da1sh1n/Alvea/kicad/bom.csv

Reference | Qty | Value | DNP | Exclude from BOM | Exclude from Board | Footprint | Datasheet | LCSC Part
C1,C2,C8 | 3 | CL05A105KA5NQNC |  |  |  | easyeda2kicad:C0402 | https://lcsc.com/datasheet/C52923.pdf | C52923
C3 | 1 | ZRB15XR61A475KE01D |  |  |  | easyeda2kicad:C0402 | https://lcsc.com/product-detail/Multilayer-Ceramic-Capacitors-MLCC-SMD-SMT_Murata-Electronics-ZRB15XR61A475KE01D_C703694.html | C703694
C4,C13,C14,C15,C16 | 5 | CL05B104KB54PNC |  |  |  | easyeda2kicad:C0402 | https://lcsc.com/datasheet/C307331.pdf | C307331
C5,C6 | 2 | 0402CG120J500NT |  |  |  | easyeda2kicad:C0402 | https://lcsc.com/datasheet/C1547.pdf | C1547
C7,C9,C10,C11,C12,C17,C18,C19 | 8 | 22uF |  |  |  | easyeda2kicad:C0805 | https://lcsc.com/product-detail/Others_Samsung-Electro-Mechanics-CL21A226KOQNNNE_C296720.html | C296720
D1 | 1 | NSR05F20NXT5G |  |  |  | easyeda2kicad:DSN2_L1.0-W0.6-RD | https://lcsc.com/product-detail/Schottky-Barrier-Diodes-SBD_ON_NSR05F20NXT5G_NSR05F20NXT5G_C94366.html | C94366
F1 | 1 | SMD1206-150C-16V |  |  |  | easyeda2kicad:F1206 |  | C2760275
H1 | 1 | HC-PM254-8.5H-1X3PW |  |  |  | :HDR-TH_3P-P2.54_HC-PM254-8.5H-1X3PW |  | C22373927
L1 | 1 | BRC2016T100K |  |  |  | :IND-SMD_L2.0-W1.6_BRC2016 | https://lcsc.com/product-detail/New-Arrivals_Taiyo-Yuden-BRC2016T100K_C223154.html | C223154
L2 | 1 | 1uH |  |  |  | easyeda2kicad:IND-SMD_L2.5-W2.0 | https://www.lcsc.com/datasheet/C1882521.pdf | C1882521
Q1 | 1 | PMF170XP,115 |  |  |  | easyeda2kicad:SOT-323-3_L2.0-W1.3-P1.30-LS2.1-BR | https://lcsc.com/product-detail/MOSFET_Nexperia-PMF170XP-115_C389353.html | C389353
Q2 | 1 | FS8205A_C2830320 |  |  |  | easyeda2kicad:SOT-23-6_L2.9-W1.6-P0.95-LS2.8-BR |  | C2830320
R1 | 1 | 14k7 1% 0805 |  |  |  | easyeda2kicad:R0805 | https://lcsc.com/product-detail/Chip-Resistor-Surface-Mount-UniOhm_14-7KR-1472-1_C17458.html | C17458
R2,R3,R10,R17 | 4 | 0402WGF5101TCE |  |  |  | easyeda2kicad:R0402 | https://lcsc.com/datasheet/C25905.pdf | C25905
R4,R5 | 2 | 0402WGF1004TCE |  |  |  | easyeda2kicad:R0402 | https://lcsc.com/datasheet/C26083.pdf | C26083
R6 | 1 | WR04W2494FTL |  |  |  | easyeda2kicad:R0402 | https://lcsc.com/product-detail/Others_Walsin-Tech-Corp-WR04W2494FTL_C368359.html | C368359
R7,R18,R19,R23 | 4 | 0402WGF1002TCE |  |  |  | easyeda2kicad:R0402 | https://lcsc.com/datasheet/C25744.pdf | C25744
R8,R11,R22,R24 | 4 | 1k |  |  |  | easyeda2kicad:R0402 | https://lcsc.com/product-detail/Chip-Resistor-Surface-Mount-UniOhm_1KR-1001-1_C11702.html | C11702
R9,R12,R14 | 3 | 0.5Ω |  |  |  | easyeda2kicad:R0402 | https://lcsc.com/product-detail/Chip-Resistor-Surface-Mount_UNI-ROYAL-Uniroyal-Elec-0402WGF500LTCE_C423160.html | C423160
R13 | 1 | RTT022614FTH |  |  |  | easyeda2kicad:R0402 | https://lcsc.com/datasheet/C166493.pdf | C166493
R15,R16,R20 | 3 | 102k |  |  |  | easyeda2kicad:R0402 | https://www.lcsc.com/datasheet/C852473.pdf | C852473
R21 | 1 | 96.5k |  |  |  | easyeda2kicad:R0402 | https://www.lcsc.com/datasheet/C852962.pdf | C852962
SW1 | 1 | TS-1088-AR02016 |  |  |  | easyeda2kicad:SW-SMD_L3.9-W3.0-P4.45 | https://lcsc.com/product-detail/Tactile-Switches_XUNPU-TS-1088-AR02016_C720477.html | C720477
U1 | 1 | E73-2G4M08S1C |  |  |  | :WIRELM-SMD_E73-2G4M08S1C | https://lcsc.com/product-detail/_Chengdu-Ebyte-Elec-Tech-E73-2G4M08S1C_C356849.html | C356849
U2 | 1 | LP5024RSMR |  |  |  | :VQFN-32_L4.0-W4.0-P0.40-TL-EP |  | C427525
U3 | 1 | IP2312 |  |  |  | easyeda2kicad:SOP-8_L4.9-W3.9-P1.27-LS6.0-BL-EP | https://lcsc.com/product-detail/DC-DC-Converters_INJOINIC-IP2312_C605432.html | C605432
U4 | 1 | SN74LVC1G74DQER |  |  |  | :X2SON-8_L1.4-W1.0-P0.35-BL |  | C2870716
U5 | 1 | SN74LVC1G17DBVR |  |  |  | easyeda2kicad:SOT-23-5_L3.0-W1.7-P0.95-LS2.8-BR | https://www.lcsc.com/datasheet/C7836.pdf | C7836
U6 | 1 | SMF5.0A |  |  |  | easyeda2kicad:SOD-123FL_L2.8-W1.8-LS3.6-RD | https://www.lcsc.com/datasheet/C2990427.pdf | C2990427
U7 | 1 | USBLC6-2SC6 |  |  |  | Package_TO_SOT_SMD:SOT-23-6 | https://www.st.com/resource/en/datasheet/usblc6-2.pdf | C7519
U8 | 1 | S2B-PH-K-S(LF)(SN) |  |  |  | :CONN-TH_S2B-PH-K-S-LF-SN | https://lcsc.com/product-detail/PH-Connectors_JST-Sales-America_S2B-PH-K-S-LF-SN_JST-Sales-America-S2B-PH-K-S-LF-SN_C173752.html | C173752
U9 | 1 | MAX17048 |  |  |  | PCM_SparkFun-Semiconductor-Standard:DFN-8_2x2mm_P0.5mm_EP1.2x0.8mm | https://www.analog.com/media/en/technical-documentation/data-sheets/MAX17048-MAX17049.pdf | C2682616
U10 | 1 | DW01A_C42380662 |  |  |  | :SOT-23-6_L2.9-W1.6-P0.95-LS2.9-BL |  | C42380662
USBC1 | 1 | TYPE-C-31-M-12 |  |  |  | easyeda2kicad:USB-C_SMD-TYPE-C-31-M-12_1 | https://lcsc.com/product-detail/USB-Type-C_Korean-Hroparts-Elec-TYPE-C-31-M-12_C165948.html | C165948
X1 | 1 | FC-13532.768KHZ9PF20PPM |  |  |  | easyeda2kicad:OSC-SMD_L3.2-W1.5 | https://lcsc.com/product-detail/SMD-Crystals_EPSON_FC-13532-768KHZ9PF20PPM_FC-135-32-768KHZ-9PF-20PPM_C99010.html | C99010
