da1sh1n/Alvea/kicad/right.pdf

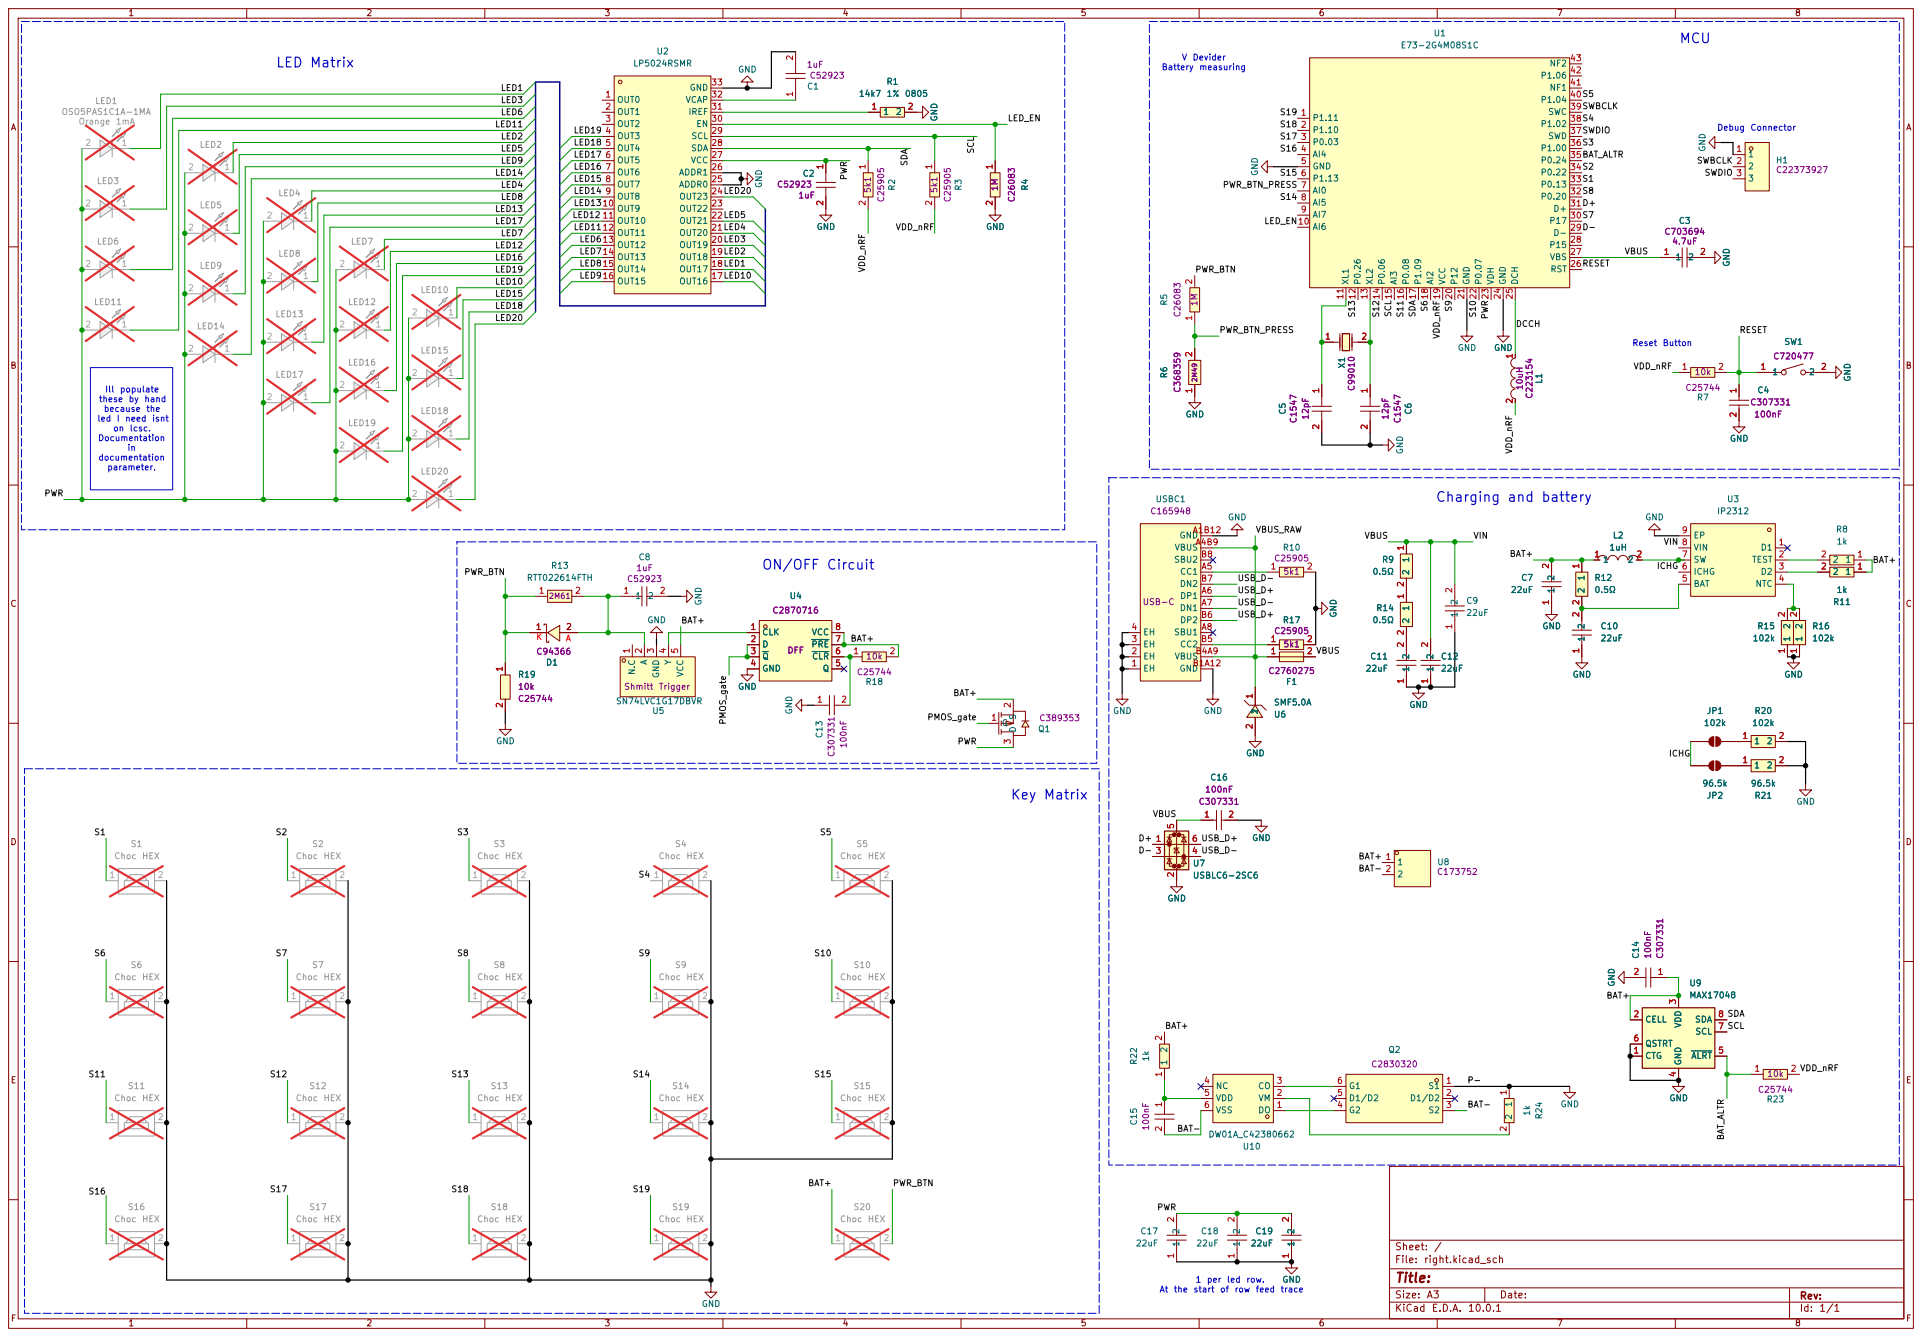
[picture p1: page 1]

Debug Connector V Devider Battery measuring

Ill populate
these by hand
because the
led I need isnt on lcsc. Documentation

1 per led row. At the start of row feed trace

Size: A3 | Rev: | F Date:
KiCad E.D.A. 10.0.1 | Id: 1/1
