da1sh1n/Alvea/kicad/right.kicad_pcb

## KiCad design kicad/right.kicad_pcb (2026-10-15)

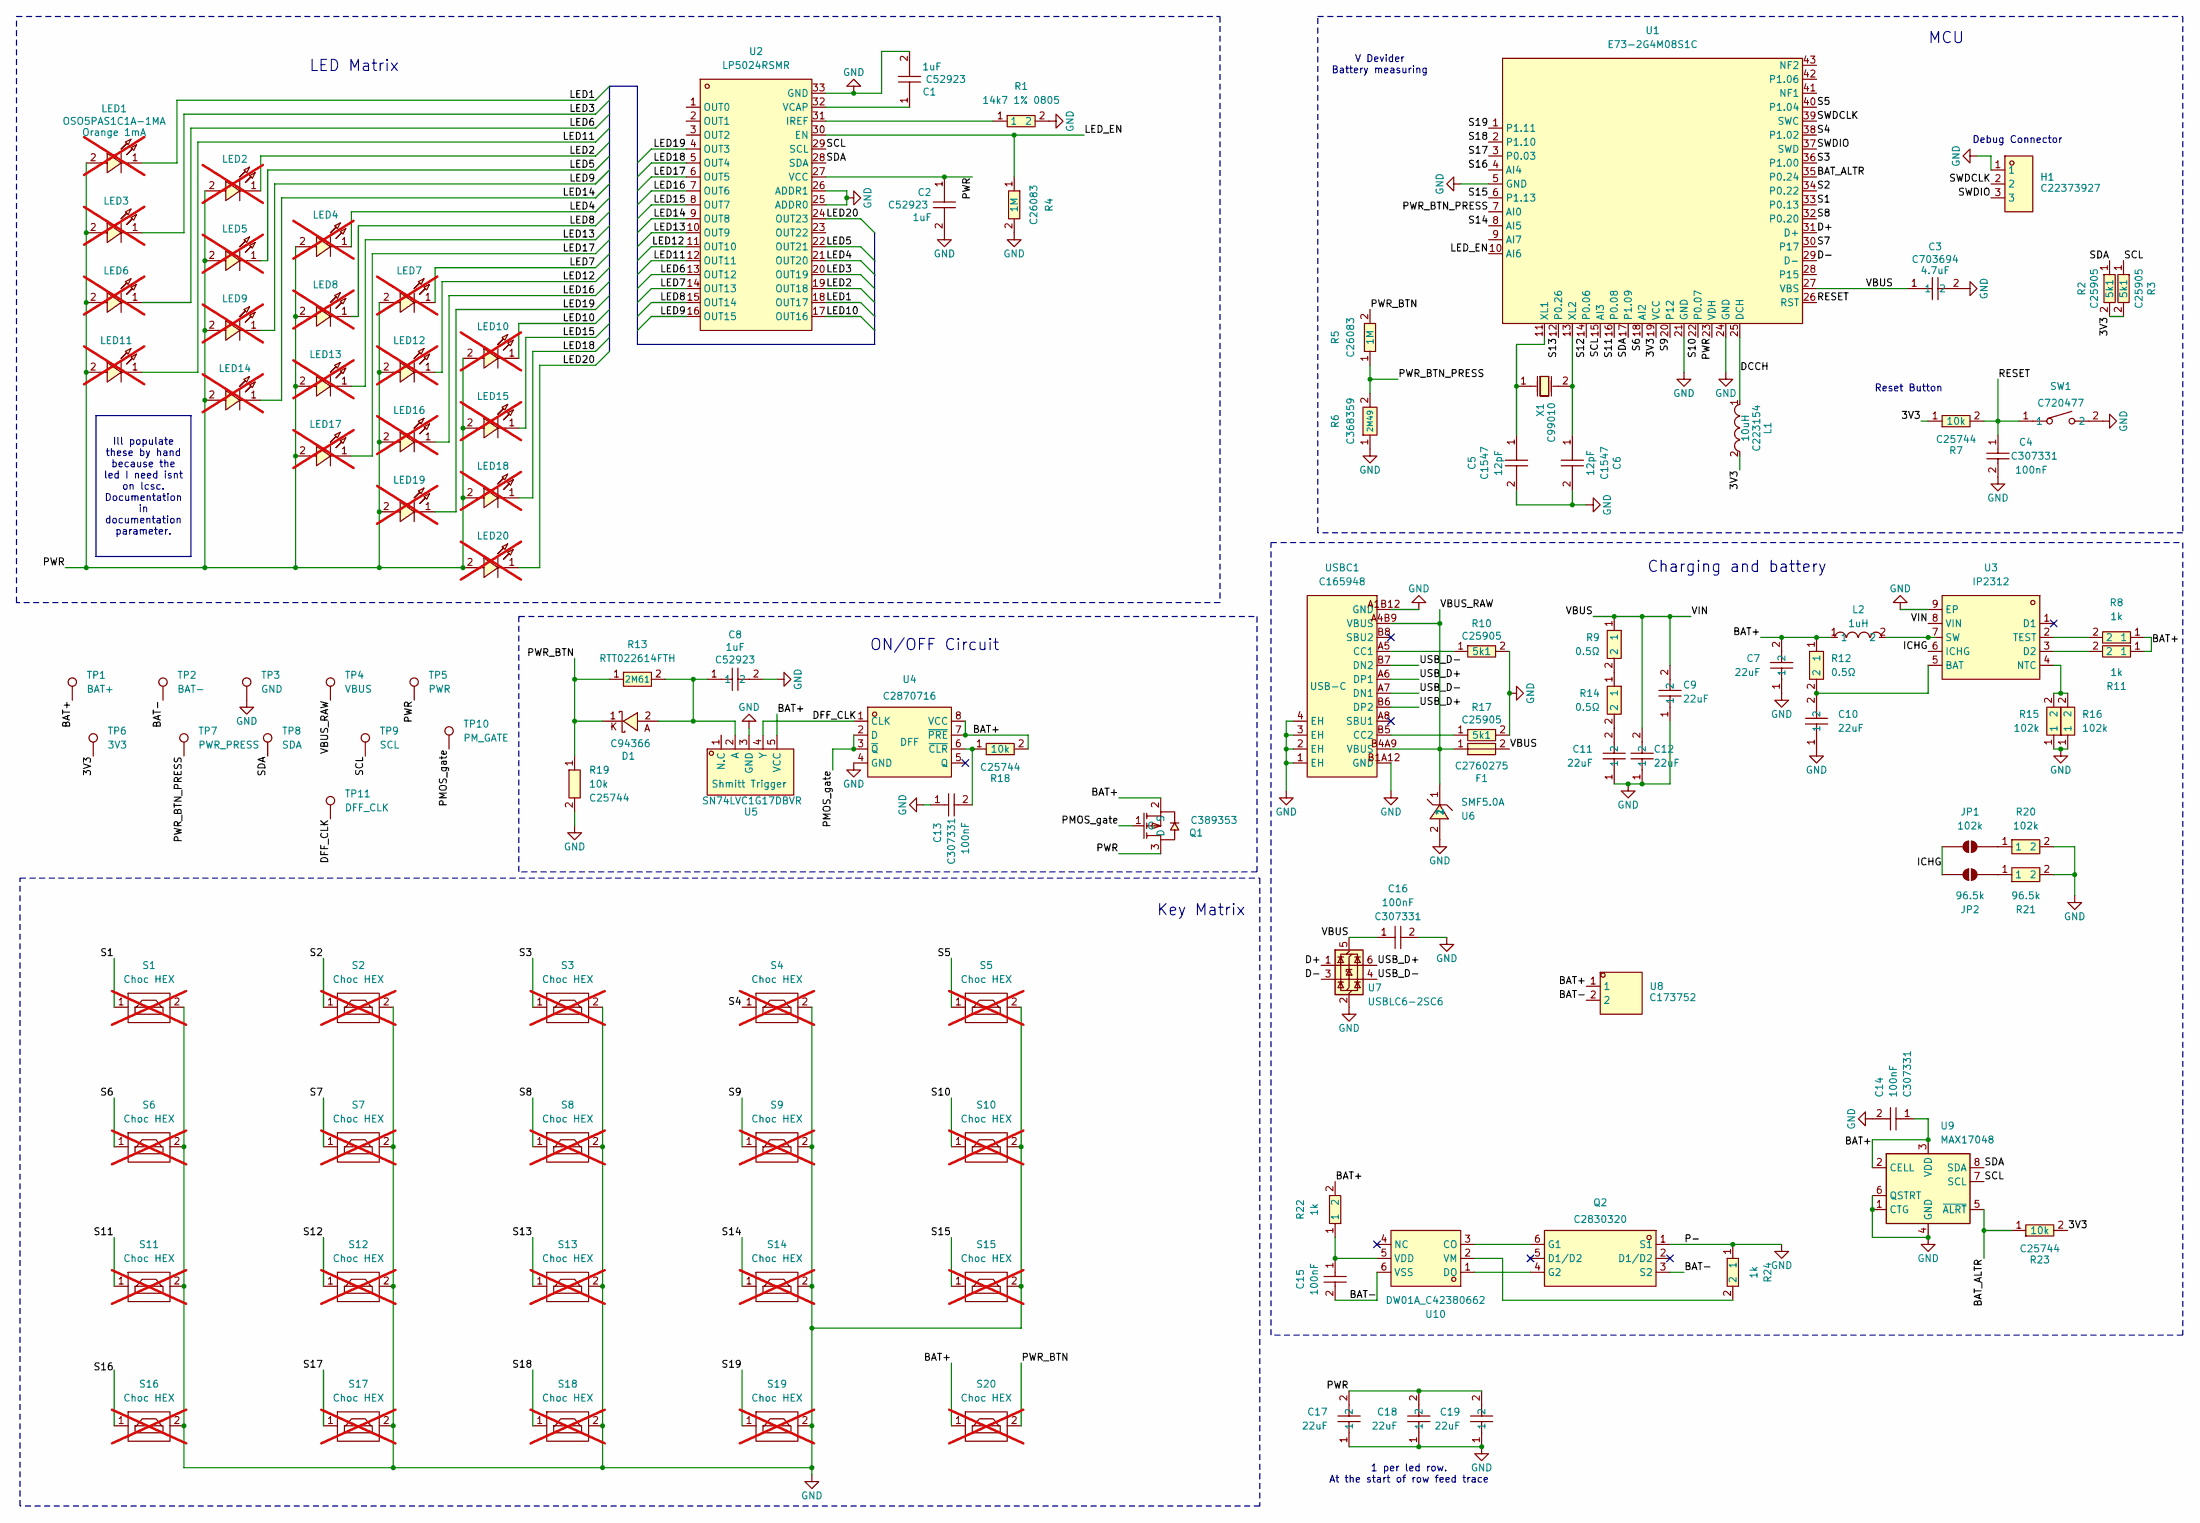
[picture p2: schematic right.kicad_sch]

Parts:
C1, C2, C8: CL05A105KA5NQNC; C0402; LCSC Part C52923
C3: ZRB15XR61A475KE01D; C0402; MPN ZRB15XR61A475KE01D; LCSC Part C703694
C4, C13, C14, C15, C16: CL05B104KB54PNC; C0402; LCSC Part C307331
C5, C6: 0402CG120J500NT; C0402; LCSC Part C1547
C7, C9, C10, C11, C12, C17, C18, C19: 22uF; C0805; MPN CL21A226KOQNNNE; LCSC Part C296720
D1: NSR05F20NXT5G; DSN2_L1.0-W0.6-RD; LCSC Part C94366
F1: SMD1206-150C-16V; F1206; LCSC Part C2760275
H1: HC-PM254-8.5H-1X3PW; HDR-TH_3P-P2.54_HC-PM254-8.5H-1X3PW; LCSC Part C22373927
JP1: 102k; SolderJumper-2_P1.3mm_Open_TrianglePad1.0x1.5mm
JP2: 96.5k; SolderJumper-2_P1.3mm_Open_TrianglePad1.0x1.5mm
L1: BRC2016T100K; IND-SMD_L2.0-W1.6_BRC2016; LCSC Part C223154
L2: 1uH; IND-SMD_L2.5-W2.0; MPN TMS252012ALM-1R0MTAA; LCSC Part C1882521
LED1, LED2, LED3, LED4, LED5, LED6, LED7, LED8, LED9, LED10, LED11, LED12, LED13, LED14, LED15, LED16, LED17, LED18, LED19, LED20: OSO5PAS1C1A-1MA; LED-SMD_L3.2-W2.8-LS3.5-RD-BLUE; LCSC Part OSO5PAS1C1A-1MA -> on tme.ue; not fitted
Q1: PMF170XP,115; SOT-323-3_L2.0-W1.3-P1.30-LS2.1-BR; LCSC Part C389353
Q2: FS8205A_C2830320; SOT-23-6_L2.9-W1.6-P0.95-LS2.8-BR; LCSC Part C2830320
R1: 14k7 1% 0805; R0805; MPN 0805W8F1472T5E; LCSC Part C17458
R2, R3, R10, R17: 0402WGF5101TCE; R0402; LCSC Part C25905
R4, R5: 0402WGF1004TCE; R0402; LCSC Part C26083
R6: WR04W2494FTL; R0402; LCSC Part C368359
R7, R18, R19, R23: 0402WGF1002TCE; R0402; LCSC Part C25744
R8, R11, R22, R24: 1k; R0402; MPN 0402WGF1001TCE; LCSC Part C11702
R9, R12, R14: 0.5Ω; R0402; MPN 0402WGF500LTCE; LCSC Part C423160
R13: RTT022614FTH; R0402; MPN RTT022614FTH; LCSC Part C166493
R15, R16, R20: 102k; R0402; MPN RT0402BRD07102KL; LCSC Part C852473
R21: 96.5k; R0402; MPN RT0402BRD0796K5L; LCSC Part C852962
S1, S2, S3, S4, S5, S6, S7, S8, S9, S10, S11, S12, S13, S14, S15, S16, S17, S18, S19, S20: Choc HEX; PG1350_hotswap_reversed; not fitted
SW1: TS-1088-AR02016; SW-SMD_L3.9-W3.0-P4.45; LCSC Part C720477
TP1: BAT+; TestPoint_Pad_D2.0mm
TP2: BAT-; TestPoint_Pad_D2.0mm
TP3: GND; TestPoint_Pad_D2.0mm
TP4: VBUS; TestPoint_Pad_D2.0mm
TP5: PWR; TestPoint_Pad_D2.0mm
TP6: 3V3; TestPoint_Pad_D2.0mm
TP7: PWR_PRESS; TestPoint_Pad_D2.0mm
TP8: SDA; TestPoint_Pad_D2.0mm
TP9: SCL; TestPoint_Pad_D2.0mm
TP10: PM_GATE; TestPoint_Pad_D2.0mm
TP11: DFF_CLK; TestPoint_Pad_D2.0mm
U1: E73-2G4M08S1C; WIRELM-SMD_E73-2G4M08S1C; LCSC Part C356849
U2: LP5024RSMR; VQFN-32_L4.0-W4.0-P0.40-TL-EP; LCSC Part C427525
U3: IP2312; SOP-8_L4.9-W3.9-P1.27-LS6.0-BL-EP; MPN IP2312U_VSET; LCSC Part C605432
U4: SN74LVC1G74DQER; X2SON-8_L1.4-W1.0-P0.35-BL; LCSC Part C2870716
U5: SN74LVC1G17DBVR; SOT-23-5_L3.0-W1.7-P0.95-LS2.8-BR; MPN SN74LVC1G17DBVR; LCSC Part C7836
U6: SMF5.0A; SOD-123FL_L2.8-W1.8-LS3.6-RD; MPN SMF5.0A; LCSC Part C2990427
U7: USBLC6-2SC6; SOT-23-6; LCSC Part C7519
U8: S2B-PH-K-S(LF)(SN); CONN-TH_S2B-PH-K-S-LF-SN; LCSC Part C173752
U9: MAX17048; DFN-8_2x2mm_P0.5mm_EP1.2x0.8mm; LCSC Part C2682616
U10: DW01A_C42380662; SOT-23-6_L2.9-W1.6-P0.95-LS2.9-BL; LCSC Part C42380662
USBC1: TYPE-C-31-M-12; USB-C_SMD-TYPE-C-31-M-12_1; LCSC Part C165948
X1: FC-13532.768KHZ9PF20PPM; OSC-SMD_L3.2-W1.5; LCSC Part C99010

Connections:
/3V3: L1.2, R2.2, R3.2, R7.1, R23.2, TP6.1 (1_1), U1.19 (VCC)
/BAT+: C7.2, C14.1, L2.1, Q1.2 (S), R8.1, R11.1, R12.1, R18.2, R22.2, S20.1, TP1.1 (1_1), U4.7 (~PRE), U4.8 (VCC), U5.5 (VCC), U8.1, U9.2 (CELL), U9.3 (VDD)
/BAT-: C15.2, Q2.3 (S2), TP2.1 (1_1), U8.2, U10.6 (VSS)
/BAT_ALTR: R23.1, U1.35 (P0.24), U9.5 (~ALRT)
/D+: U1.31 (D+), U7.1 (I/O1)
/D-: U1.29 (D-), U7.3 (I/O2)
/DCCH: L1.1, U1.25 (DCH)
/DFF_CLK: TP11.1 (1_1), U4.1 (CLK), U5.4 (Y)
/ICHG: JP1.1 (A), JP2.1 (A), U3.6 (ICHG)
/LED1: LED1.1, U2.18 (OUT17)
/LED2: LED2.1, U2.19 (OUT18)
/LED3: LED3.1, U2.20 (OUT19)
/LED4: LED4.1, U2.21 (OUT20)
/LED5: LED5.1, U2.22 (OUT21)
/LED6: LED6.1, U2.13 (OUT12)
/LED7: LED7.1, U2.14 (OUT13)
/LED8: LED8.1, U2.15 (OUT14)
/LED9: LED9.1, U2.16 (OUT15)
/LED10: LED10.1, U2.17 (OUT16)
/LED11: LED11.1, U2.12 (OUT11)
/LED12: LED12.1, U2.11 (OUT10)
/LED13: LED13.1, U2.10 (OUT9)
/LED14: LED14.1, U2.9 (OUT8)
/LED15: LED15.1, U2.8 (OUT7)
/LED16: LED16.1, U2.7 (OUT6)
/LED17: LED17.1, U2.6 (OUT5)
/LED18: LED18.1, U2.5 (OUT4)
/LED19: LED19.1, U2.4 (OUT3)
/LED20: LED20.1, U2.24 (OUT23)
/LED_EN: R4.1, U1.10 (AI6), U2.30 (EN)
/PMOS_gate: Q1.1 (G), TP10.1 (1_1), U4.2 (D), U4.3 (~Q)
/PWR: C2.1, C17.2, C18.2, C19.2, LED1.2, LED2.2, LED3.2, LED4.2, LED5.2, LED6.2, LED7.2, LED8.2, LED9.2, LED10.2, LED11.2, LED12.2, LED13.2, LED14.2, LED15.2, LED16.2, LED17.2, LED18.2, LED19.2, LED20.2, Q1.3 (D), TP5.1 (1_1), U1.23 (VDH), U2.27 (VCC)
/PWR_BTN: D1.1, R5.2, R13.1, R19.1, S20.2
/PWR_BTN_PRESS: R5.1, R6.2, TP7.1 (1_1), U1.7 (AI0)
/RESET: C4.1, R7.2, SW1.1, U1.26 (RST)
/S1: S1.1, U1.33 (P0.13)
/S2: S2.1, U1.34 (P0.22)
/S3: S3.1, U1.36 (P1.00)
/S4: S4.1, U1.38 (P1.02)
/S5: S5.1, U1.40 (P1.04)
/S6: S6.1, U1.18 (AI2)
/S7: S7.1, U1.30 (P17)
/S8: S8.1, U1.32 (P0.20)
/S9: S9.1, U1.20 (P12)
/S10: S10.1, U1.22 (P0.07)
/S11: S11.1, U1.16 (P0.08)
/S12: S12.1, U1.14 (P0.06)
/S13: S13.1, U1.12 (P0.26)
/S14: S14.1, U1.8 (AI5)
/S15: S15.1, U1.6 (P1.13)
/S16: S16.1, U1.4 (AI4)
/S17: S17.1, U1.3 (P0.03)
/S18: S18.1, U1.2 (P1.10)
/S19: S19.1, U1.1 (P1.11)
/SCL: R3.1, TP9.1 (1_1), U1.15 (AI3), U2.29 (SCL), U9.7 (SCL)
/SDA: R2.1, TP8.1 (1_1), U1.17 (P1.09), U2.28 (SDA), U9.8 (SDA)
/SWDCLK: H1.2, U1.39 (SWC)
/SWDIO: H1.3, U1.37 (SWD)
/USB_D+: U7.6 (I/O1), USBC1.A6 (DP1), USBC1.B6 (DP2)
/USB_D-: U7.4 (I/O2), USBC1.A7 (DN1), USBC1.B7 (DN2)
/VBUS: C3.1, C9.2, C12.2, C16.1, F1.2, R9.1, U1.27 (VBS), U3.8 (VIN), U7.5 (VBUS)
/VBUS_RAW: F1.1, TP4.1 (1_1), U6.1, USBC1.A4B9 (VBUS), USBC1.B4A9 (VBUS)
GND: C1.2, C2.2, C3.2, C4.2, C5.2, C6.2, C7.1, C8.2, C9.1, C10.1, C11.1, C12.1, C13.1, C14.2, C16.2, C17.1, C18.1, C19.1, H1.1, Q2.1 (S1), R1.2, R4.2, R6.1, R10.2, R15.1, R16.1, R17.2, R19.2, R20.2, R21.2, R24.1, S1.2, S2.2, S3.2, S4.2, S5.2, S6.2, S7.2, S8.2, S9.2, S10.2, S11.2, S12.2, S13.2, S14.2, S15.2, S16.2, S17.2, S18.2, S19.2, SW1.2, TP3.1 (1_1), U1.5 (GND), U1.21 (GND), U1.24 (GND), U2.25 (ADDR0), U2.26 (ADDR1), U2.33 (GND), U3.9 (EP), U4.4 (GND), U5.3 (GND), U6.2, U7.2 (GND), U9.1 (CTG), U9.4 (GND), U9.6 (QSTRT), U9.9 (GND), USBC1.1 (EH), USBC1.2 (EH), USBC1.3 (EH), USBC1.4 (EH), USBC1.A1B12 (GND), USBC1.B1A12 (GND)
unnamed: C11.2, R14.2
unnamed: JP1.2 (B), R20.1
unnamed: JP2.2 (B), R21.1
unnamed: Q2.6 (G1), U10.3 (CO)
unnamed: Q2.4 (G2), U10.1 (DO)
unnamed: R9.2, R14.1
unnamed: C5.1, U1.11 (XL1), X1.1
unnamed: C6.1, U1.13 (XL2), X1.2
unnamed: R1.1, U2.31 (IREF)
unnamed: C1.1, U2.32 (VCAP)
unnamed: C10.2, R12.2, U3.5 (BAT)
unnamed: R11.2, U3.3 (D2)
unnamed: R15.2, R16.2, U3.4 (NTC)
unnamed: L2.2, U3.7 (SW)
unnamed: R8.2, U3.2 (TEST)
unnamed: C13.2, R18.1, U4.6 (~CLR)
unnamed: C8.1, D1.2, R13.2, U5.2 (A)
unnamed: C15.1, R22.1, U10.5 (VDD)
unnamed: R24.2, U10.2 (VM)
unnamed: R10.1, USBC1.A5 (CC1)
unnamed: R17.1, USBC1.B5 (CC2)

Notes on the sheet:
Charging and battery
MCU
Debug Connector
ON/OFF Circuit
Reset Button
Key Matrix
V Devider Battery measuring
LED Matrix
1 per led row. At the start of row feed trace
Ill populate these by hand because the led I need isnt on lcsc. Documentation in documentation parameter.

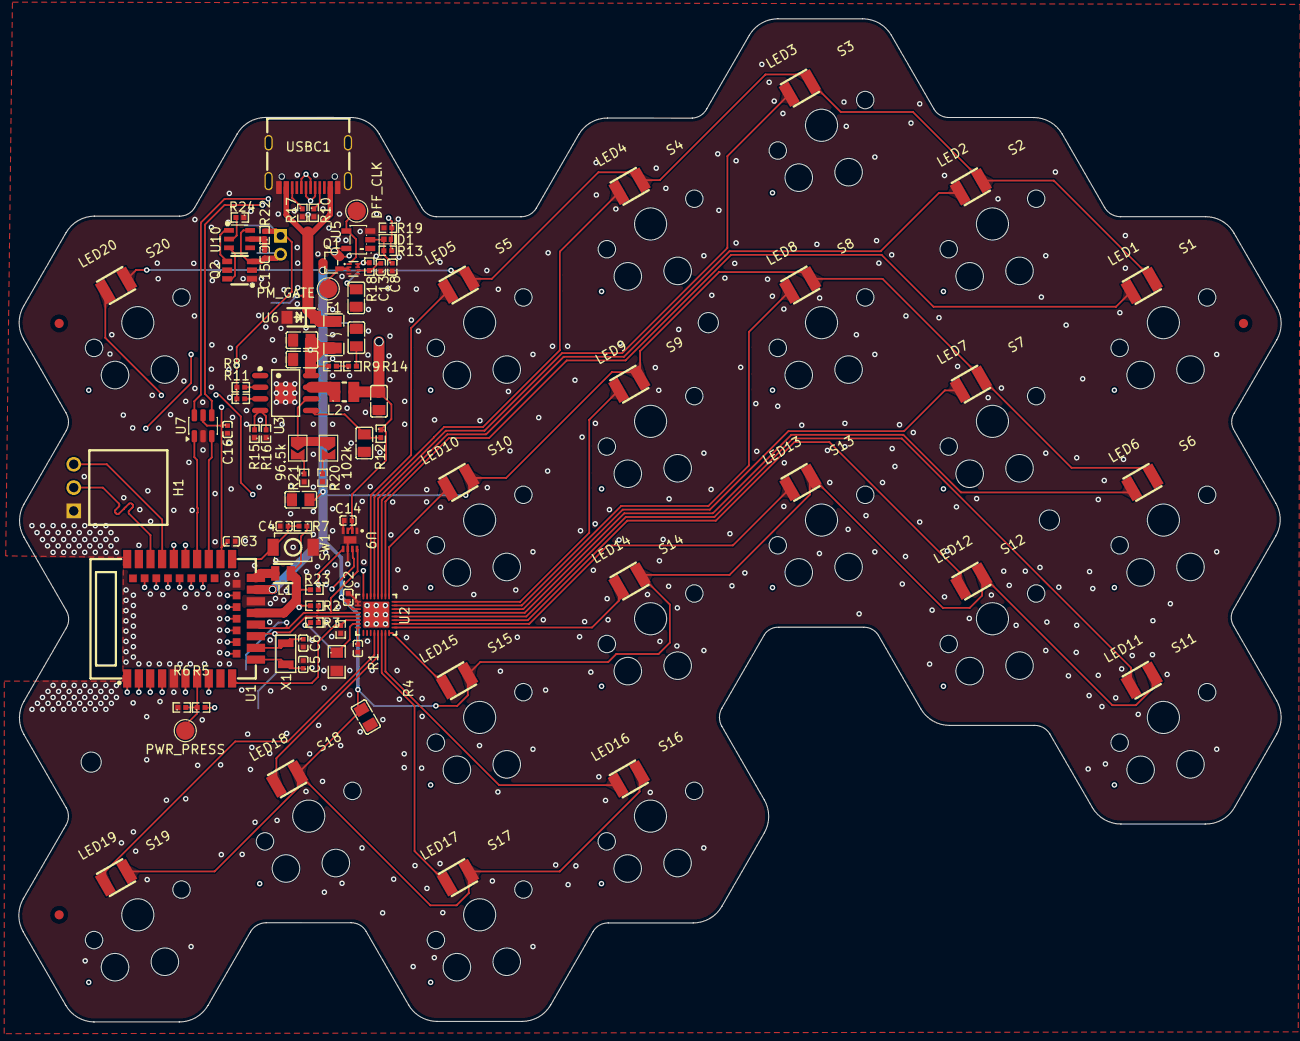
[picture p3: board right.kicad_pcb from above]

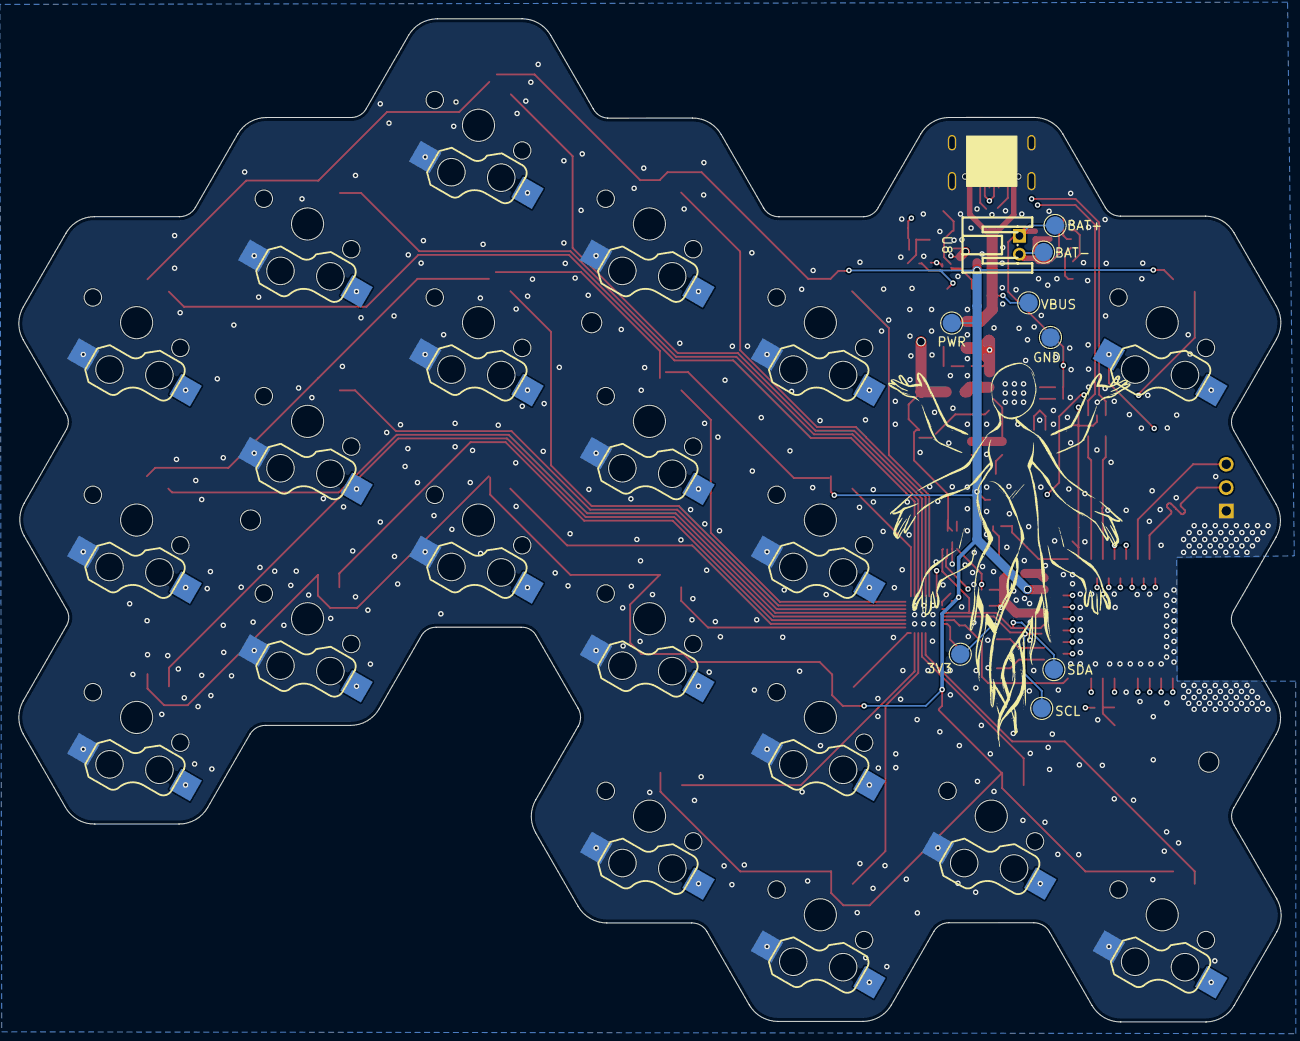
[picture p4: board right.kicad_pcb from below]

Board: 4 copper layers, 137.5 x 109.3 mm, 120 parts (30 on the bottom side), 84 nets.

Other parts of the board:
Fi4, Fi5: Fiducial_1mm_Mask2mm
Fi6: Fiducial_1mm_Mask2mm
G**: LOGO; handy
