da1sh1n/Alvea/kicad/left.kicad_pcb

## KiCad design kicad/left.kicad_pcb (2026-09-28)

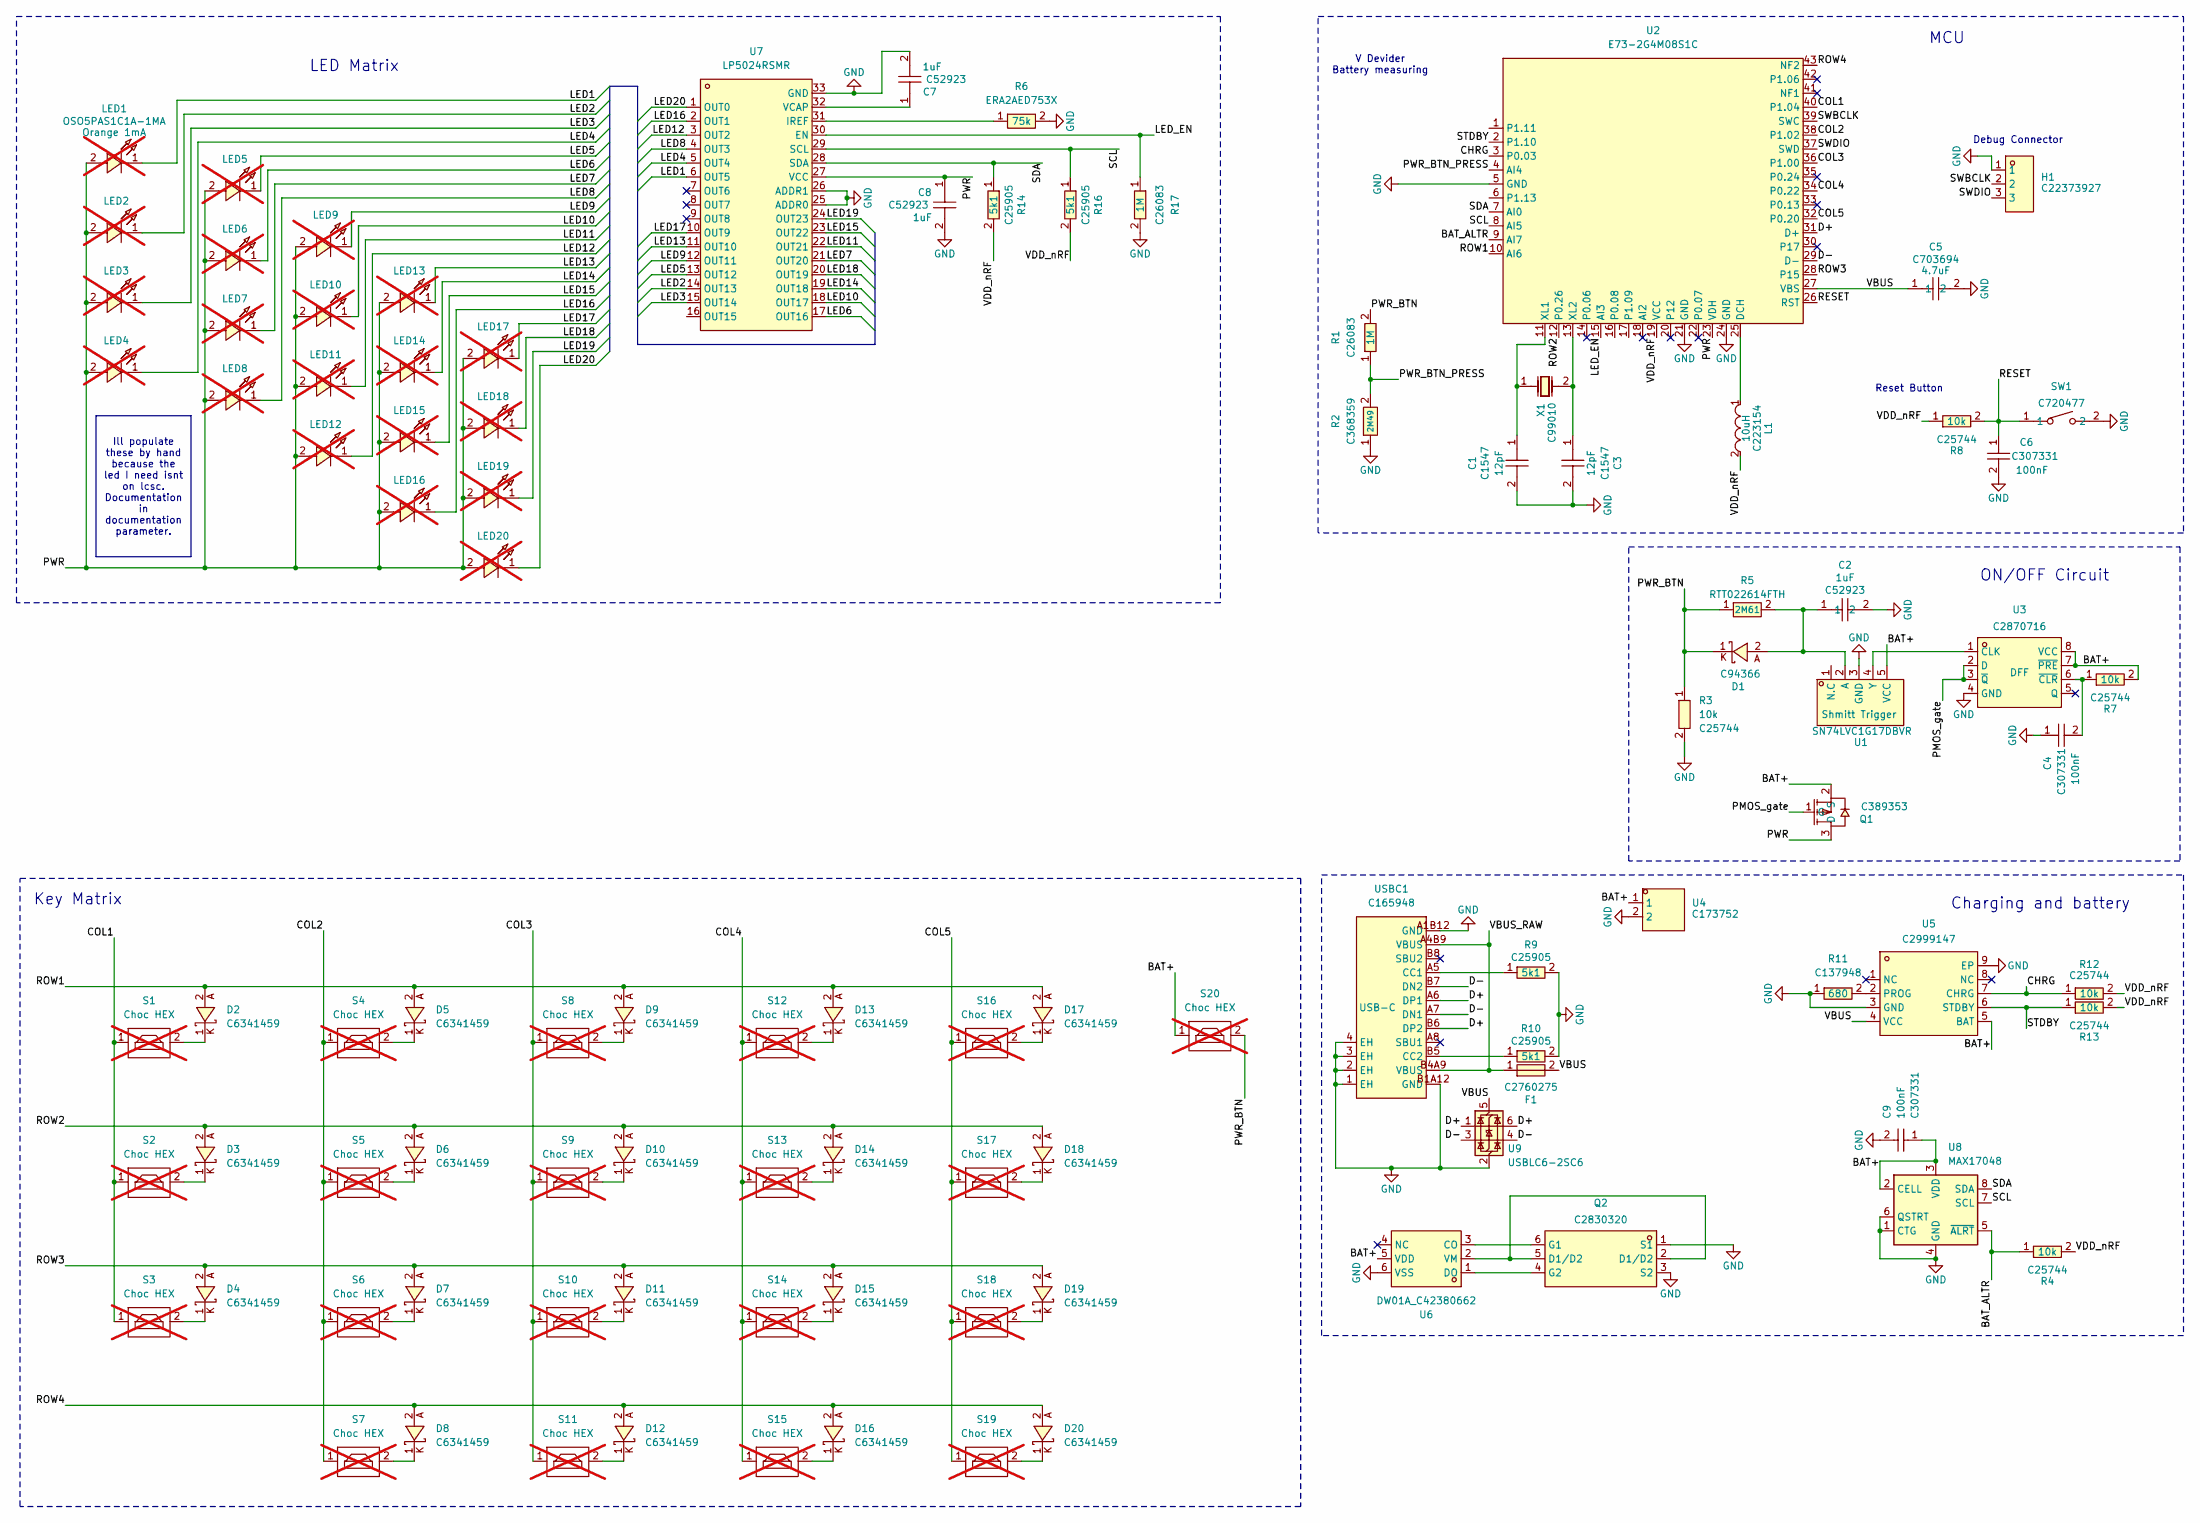
[picture p5: schematic left.kicad_sch]

Parts:
C1, C3: 0402CG120J500NT; C0402; LCSC Part C1547
C2, C7, C8: CL05A105KA5NQNC; C0402; LCSC Part C52923
C4, C6, C9: CL05B104KB54PNC; C0402; LCSC Part C307331
C5: ZRB15XR61A475KE01D; C0402; MPN ZRB15XR61A475KE01D; LCSC Part C703694
D1: NSR05F20NXT5G; DSN2_L1.0-W0.6-RD; LCSC Part C94366
D2, D3, D4, D5, D6, D7, D8, D9, D10, D11, D12, D13, D14, D15, D16, D17, D18, D19, D20: CDSQC4148-HF; X1-DFN1006-2_L1.0-W0.6-RD; LCSC Part C6341459
F1: SMD1206-150C-16V; F1206; LCSC Part C2760275
H1: HC-PM254-8.5H-1X3PW; HDR-TH_3P-P2.54_HC-PM254-8.5H-1X3PW; LCSC Part C22373927
L1: BRC2016T100K; IND-SMD_L2.0-W1.6_BRC2016; LCSC Part C223154
LED1, LED2, LED3, LED4, LED5, LED6, LED7, LED8, LED9, LED10, LED11, LED12, LED13, LED14, LED15, LED16, LED17, LED18, LED19, LED20: OSO5PAS1C1A-1MA; LED-SMD_L3.2-W2.8-LS3.5-RD-BLUE; LCSC Part OSO5PAS1C1A-1MA -> on tme.ue; not fitted
Q1: PMF170XP,115; SOT-323-3_L2.0-W1.3-P1.30-LS2.1-BR; LCSC Part C389353
Q2: FS8205A_C2830320; SOT-23-6_L2.9-W1.6-P0.95-LS2.8-BR; LCSC Part C2830320
R1, R17: 0402WGF1004TCE; R0402; LCSC Part C26083
R2: WR04W2494FTL; R0402; LCSC Part C368359
R3, R4, R7, R8, R12, R13: 0402WGF1002TCE; R0402; LCSC Part C25744
R5: RTT022614FTH; R0402; MPN RTT022614FTH; LCSC Part C166493
R6: ERA2AED753X; R0402; MPN ERA2AED753X; LCSC Part C491105
R9, R10, R14, R16: 0402WGF5101TCE; R0402; LCSC Part C25905
R11: RC0402FR-07680RL; R0402; LCSC Part C137948
S1, S2, S3, S4, S5, S6, S7, S8, S9, S10, S11, S12, S13, S14, S15, S16, S17, S18, S19, S20: Choc HEX; PG1350_hotswap_reversed; not fitted
SW1: TS-1088-AR02016; SW-SMD_L3.9-W3.0-P4.45; LCSC Part C720477
U1: SN74LVC1G17DBVR; SOT-23-5_L3.0-W1.7-P0.95-LS2.8-BR; MPN SN74LVC1G17DBVR; LCSC Part C7836
U2: E73-2G4M08S1C; WIRELM-SMD_E73-2G4M08S1C; LCSC Part C356849
U3: SN74LVC1G74DQER; X2SON-8_L1.4-W1.0-P0.35-BL; LCSC Part C2870716
U4: S2B-PH-K-S(LF)(SN); CONN-TH_S2B-PH-K-S-LF-SN; LCSC Part C173752
U5: BL8573CS8TR; ESOP-8_L4.9-W3.9-P1.27-LS6.0-BL-EP; LCSC Part C2999147
U6: DW01A_C42380662; SOT-23-6_L2.9-W1.6-P0.95-LS2.9-BL; LCSC Part C42380662
U7: LP5024RSMR; VQFN-32_L4.0-W4.0-P0.40-TL-EP; LCSC Part C427525
U8: MAX17048; DFN-8_2x2mm_P0.5mm_EP1.2x0.8mm; LCSC Part C2682616
U9: USBLC6-2SC6; SOT-23-6; LCSC Part C7519
USBC1: TYPE-C-31-M-12; USB-C_SMD-TYPE-C-31-M-12_1; LCSC Part C165948
X1: FC-13532.768KHZ9PF20PPM; OSC-SMD_L3.2-W1.5; LCSC Part C99010

Connections:
/BAT+: C9.1, Q1.2 (S), R7.2, S20.1, U1.5 (VCC), U3.7 (~PRE), U3.8 (VCC), U4.1, U5.5 (BAT), U6.5 (VDD), U8.2 (CELL), U8.3 (VDD); also elsewhere on the board
/BAT_ALTR: R4.1, U2.9 (AI7), U8.5 (~ALRT)
/CHRG: R12.1, U2.3 (P0.03), U5.7 (CHRG)
/COL1: S1.1, S2.1, S3.1, U2.40 (P1.04)
/COL2: S4.1, S5.1, S6.1, S7.1, U2.38 (P1.02)
/COL3: S8.1, S9.1, S10.1, S11.1, U2.36 (P1.00)
/COL4: S12.1, S13.1, S14.1, S15.1, U2.34 (P0.22)
/COL5: S16.1, S17.1, S18.1, S19.1, U2.32 (P0.20)
/D+: U2.31 (D+), U9.1 (I/O1), U9.6 (I/O1), USBC1.A6 (DP1), USBC1.B6 (DP2)
/D-: U2.29 (D-), U9.3 (I/O2), U9.4 (I/O2), USBC1.A7 (DN1), USBC1.B7 (DN2)
/LED1: LED1.1, U7.6 (OUT5)
/LED2: LED2.1, U7.14 (OUT13)
/LED3: LED3.1, U7.15 (OUT14)
/LED4: LED4.1, U7.5 (OUT4)
/LED5: LED5.1, U7.13 (OUT12)
/LED6: LED6.1, U7.17 (OUT16)
/LED7: LED7.1, U7.21 (OUT20)
/LED8: LED8.1, U7.4 (OUT3)
/LED9: LED9.1, U7.12 (OUT11)
/LED10: LED10.1, U7.18 (OUT17)
/LED11: LED11.1, U7.22 (OUT21)
/LED12: LED12.1, U7.3 (OUT2)
/LED13: LED13.1, U7.11 (OUT10)
/LED14: LED14.1, U7.19 (OUT18)
/LED15: LED15.1, U7.23 (OUT22)
/LED16: LED16.1, U7.2 (OUT1)
/LED17: LED17.1, U7.10 (OUT9)
/LED18: LED18.1, U7.20 (OUT19)
/LED19: LED19.1, U7.24 (OUT23)
/LED20: LED20.1, U7.1 (OUT0)
/LED_EN: R17.1, U2.15 (AI3), U7.30 (EN)
/PMOS_gate: Q1.1 (G), U3.2 (D), U3.3 (~Q)
/PWR: C8.1, LED1.2, LED2.2, LED3.2, LED4.2, LED5.2, LED6.2, LED7.2, LED8.2, LED9.2, LED10.2, LED11.2, LED12.2, LED13.2, LED14.2, LED15.2, LED16.2, LED17.2, LED18.2, LED19.2, LED20.2, Q1.3 (D), U2.23 (VDH), U7.27 (VCC); also elsewhere on the board
/PWR_BTN: D1.1, R1.2, R3.1, R5.1, S20.2
/PWR_BTN_PRESS: R1.1, R2.2, U2.4 (AI4)
/RESET: C6.1, R8.2, SW1.1, U2.26 (RST)
/ROW1: D2.2, D5.2, D9.2, D13.2, D17.2, U2.10 (AI6)
/ROW2: D3.2, D6.2, D10.2, D14.2, D18.2, U2.12 (P0.26)
/ROW3: D4.2, D7.2, D11.2, D15.2, D19.2, U2.28 (P15)
/ROW4: D8.2, D12.2, D16.2, D20.2, U2.43 (NF2)
/SCL: R16.1, U2.8 (AI5), U7.29 (SCL), U8.7 (SCL)
/SDA: R14.1, U2.7 (AI0), U7.28 (SDA), U8.8 (SDA)
/STDBY: R13.1, U2.2 (P1.10), U5.6 (STDBY)
/SWBCLK: H1.2, U2.39 (SWC)
/SWDIO: H1.3, U2.37 (SWD)
/VBUS: C5.1, F1.2, U2.27 (VBS), U5.4 (VCC), U9.5 (VBUS); also elsewhere on the board
/VBUS_RAW: F1.1, USBC1.A4B9 (VBUS), USBC1.B4A9 (VBUS)
/VDD_nRF: L1.2, R4.2, R8.1, R12.2, R13.2, R14.2, R16.2, U2.19 (VCC); also elsewhere on the board
GND: C1.2, C2.2, C3.2, C4.1, C5.2, C6.2, C7.2, C8.2, C9.2, H1.1, Q2.1 (S1), Q2.3 (S2), R2.1, R3.2, R6.2, R9.2, R10.2, R11.1, R17.2, SW1.2, U1.3 (GND), U2.5 (GND), U2.21 (GND), U2.24 (GND), U3.4 (GND), U4.2, U5.3 (GND), U5.9 (EP), U6.6 (VSS), U7.25 (ADDR0), U7.26 (ADDR1), U7.33 (GND), U8.1 (CTG), U8.4 (GND), U8.6 (QSTRT), U8.9 (GND), U9.2 (GND), USBC1.1 (EH), USBC1.2 (EH), USBC1.3 (EH), USBC1.4 (EH), USBC1.A1B12 (GND), USBC1.B1A12 (GND); also elsewhere on the board
unnamed: D2.1, S1.2
unnamed: D3.1, S2.2
unnamed: D4.1, S3.2
unnamed: D5.1, S4.2
unnamed: D6.1, S5.2
unnamed: D7.1, S6.2
unnamed: D8.1, S7.2
unnamed: D9.1, S8.2
unnamed: D10.1, S9.2
unnamed: D11.1, S10.2
unnamed: D12.1, S11.2
unnamed: D13.1, S12.2
unnamed: D14.1, S13.2
unnamed: D15.1, S14.2
unnamed: D16.1, S15.2
unnamed: D17.1, S16.2
unnamed: D18.1, S17.2
unnamed: D19.1, S18.2
unnamed: D20.1, S19.2
unnamed: Q2.6 (G1), U6.3 (CO)
unnamed: Q2.4 (G2), U6.1 (DO)
unnamed: C2.1, D1.2, R5.2, U1.2 (A)
unnamed: U1.4 (Y), U3.1 (CLK)
unnamed: L1.1, U2.25 (DCH)
unnamed: C1.1, U2.11 (XL1), X1.1
unnamed: C3.1, U2.13 (XL2), X1.2
unnamed: C4.2, R7.1, U3.6 (~CLR)
unnamed: R11.2, U5.2 (PROG)
unnamed: Q2.2 (D1/D2), Q2.5 (D1/D2), U6.2 (VM)
unnamed: R6.1, U7.31 (IREF)
unnamed: C7.1, U7.32 (VCAP)
unnamed: R9.1, USBC1.A5 (CC1)
unnamed: R10.1, USBC1.B5 (CC2)

Notes on the sheet:
Debug Connector
Reset Button
MCU
LED Matrix
Charging and battery
ON/OFF Circuit
Key Matrix
V Devider Battery measuring
Ill populate these by hand because the led I need isnt on lcsc. Documentation in documentation parameter.

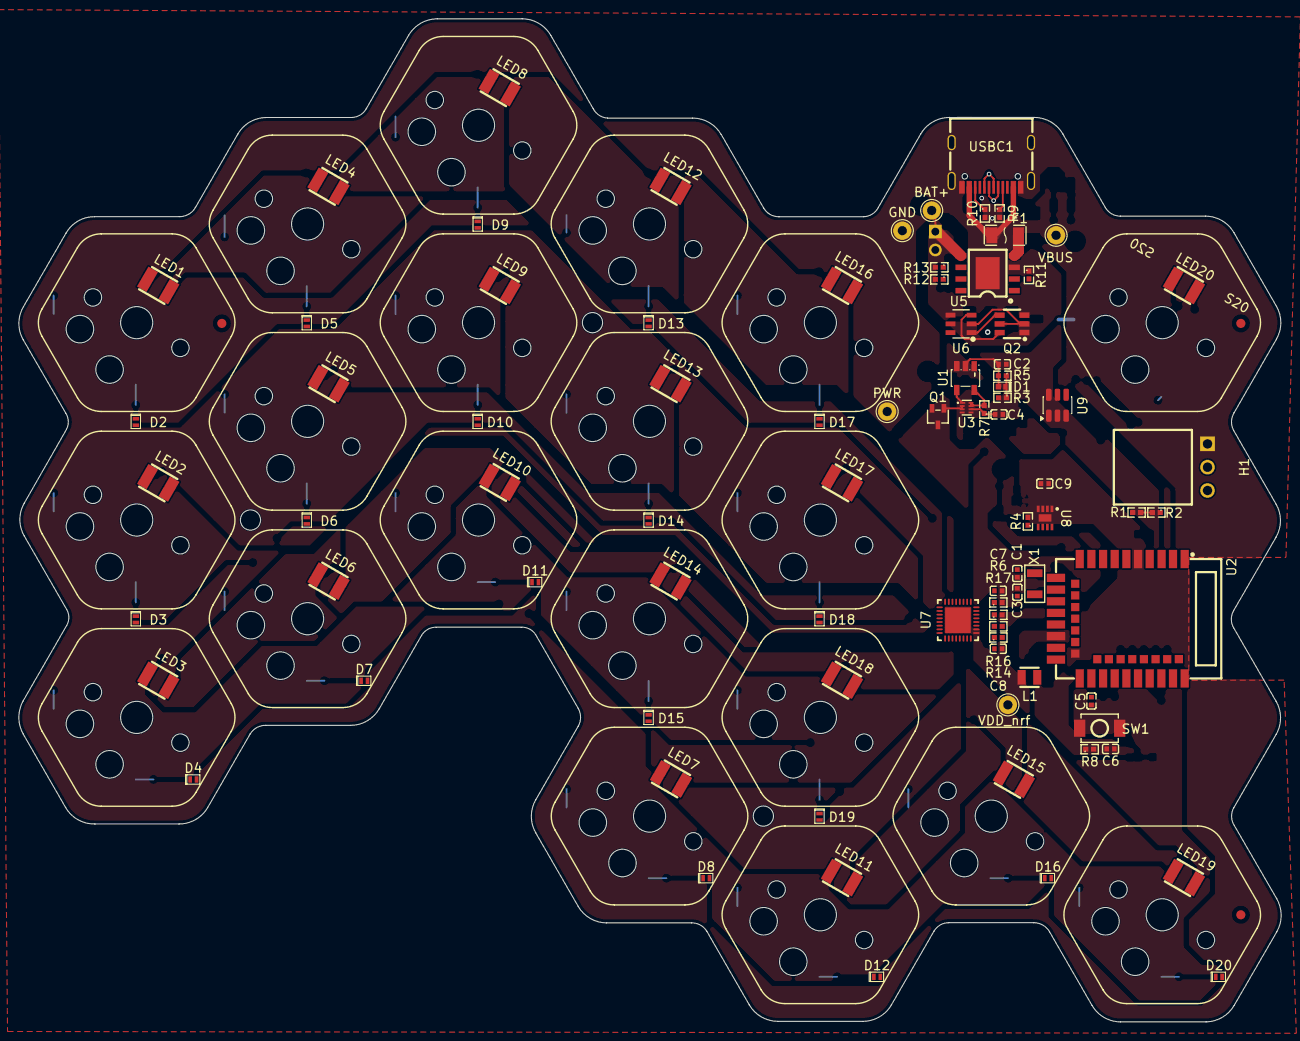
[picture p6: board left.kicad_pcb from above]

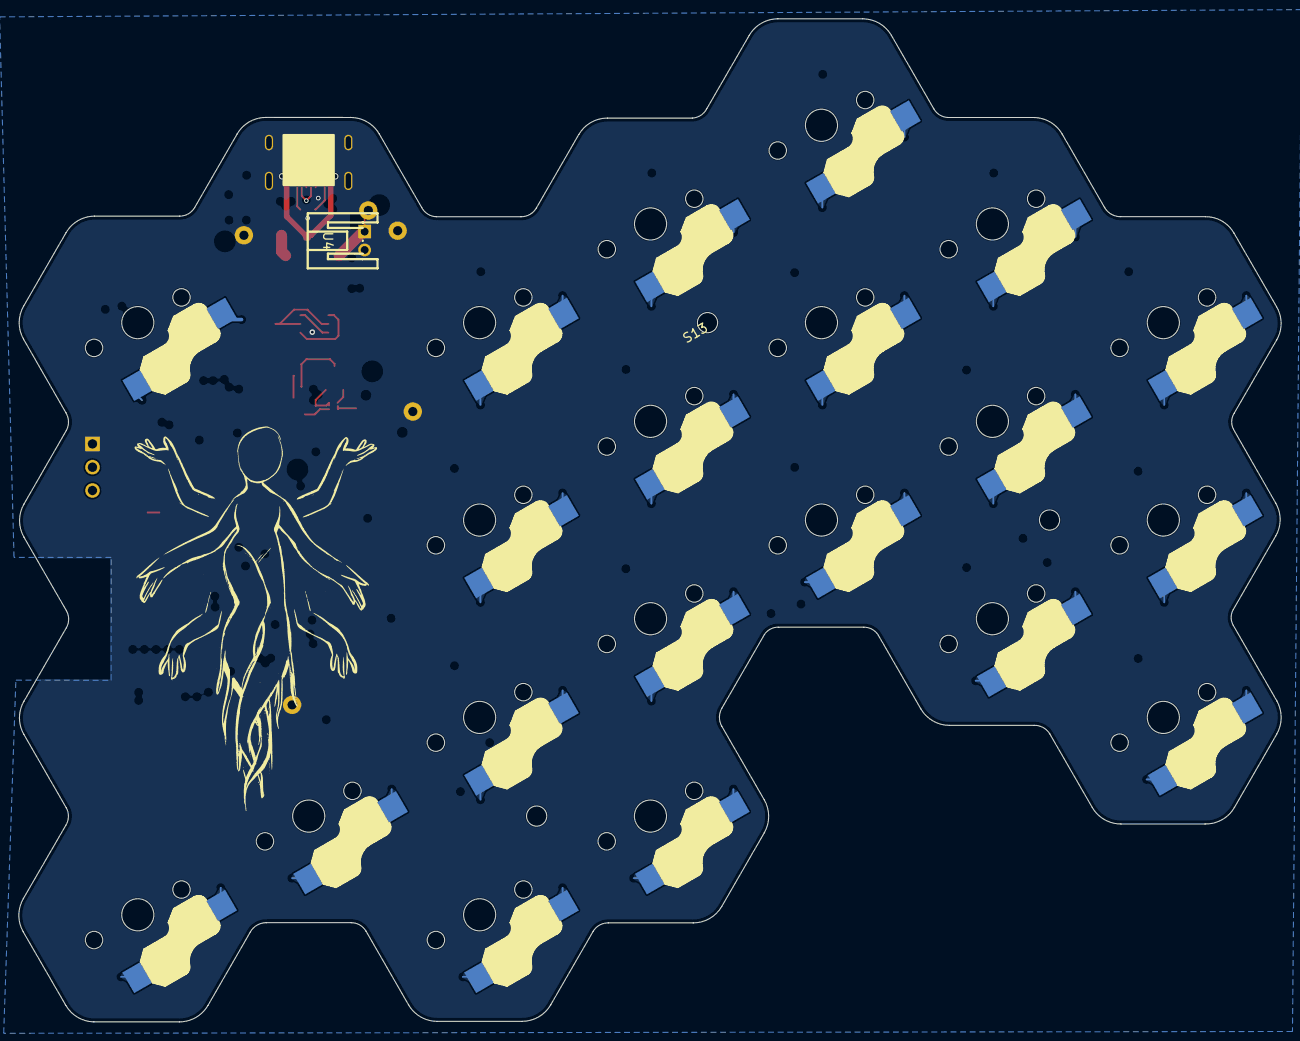
[picture p7: board left.kicad_pcb from below]

Board: 4 copper layers, 137.5 x 109.3 mm, 111 parts (2 on the bottom side), 82 nets.

Other parts of the board:
BAT+: TestPoint_THTPad_D2.0mm_Drill1.0mm
Fi1, Fi2, Fi3: Fiducial_1mm_Mask2mm
G**: LOGO; handy
GND: TestPoint_THTPad_D2.0mm_Drill1.0mm
PWR: TestPoint_THTPad_D2.0mm_Drill1.0mm
VBUS: TestPoint_THTPad_D2.0mm_Drill1.0mm
VDD_nrf: TestPoint_THTPad_D2.0mm_Drill1.0mm

Their connections:
/BAT+: BAT+.1; also elsewhere on the board
/PWR: PWR.1; also elsewhere on the board
/VBUS: VBUS.1; also elsewhere on the board
/VDD_nRF: VDD_nrf.1; also elsewhere on the board
GND: GND.1; also elsewhere on the board
