da1sh1n/Alvea/(commit log)

2026-08-19 rewired and finalized right side. updated panel. changed dnp of some components on both sides
    [left.kicad_pcb, panel.csv, panel.kicad_pcb, panel_bom.csv, panel_positions.csv, right.kicad_pcb, right.kicad_sch]
2026-09-14 fixed u9 to have pin 5 after polyfuse
    [left.kicad_pcb, left.kicad_sch]
2026-09-28 plan for changing charger. reason = heat
    [left.kicad_pcb, left_bom.csv, left_designators.csv, left_positions.csv, right.kicad_pcb]
2026-09-28 first section almost done
    [right.kicad_sch]
2026-10-01 docs: update charger protection and bring-up checklist
    - document selectable 96.5 kΩ and 102 kΩ charge-current settings
    - add USB-C TVS and 1.5 A polyfuse protection details
    - update IP2312U charger and DW01A protection wiring
    - mark completed schematic and ERC checklist items
    - revise PCB placement, routing, BOM, and bring-up procedures
    [right.kicad_pcb, right.kicad_sch]
2026-10-10 finished right part. changed inductor for charger, changed resistor for driver, and added some caps.
